tombatron/freddy-animatronic/docs/phase2-pcb.md

# Phase 2: controller PCB (rev A, first draft)

A carrier board that replaces the stock SD03-122. The ESP32-S3 and the power and driver parts are off-the-shelf modules on headers, so rev A is easy to hand-solder, debug and rework. A later revision can put the parts directly on the board once the design has proven itself.

**Status:** schematic draft and placement sketch. Not in KiCad yet. Modules are ordered (generic DRV8876, TB6612 and MP1584 boards instead of the Pololu ones first planned); their footprints get confirmed from the real boards before layout. The [power test](phase2-power-test.md) is the last design check.

| Sheet | File |
| --- | --- |
| 1. Power | [controller_power.svg](../schematics/controller_power.svg) |
| 2. Motor drivers | [controller_motors.svg](../schematics/controller_motors.svg) |
| 3. Elbows, sensors, inputs | [controller_signals.svg](../schematics/controller_signals.svg) |
| 4. Audio | [controller_audio.svg](../schematics/controller_audio.svg) |
| 5. ESP32-S3 pin map | [controller_esp32.svg](../schematics/controller_esp32.svg) |
| Placement (to scale) | [placement.svg](../hardware/controller/placement.svg) |
| BOM | [bom.csv](../hardware/controller/bom.csv) |
| Net list | [netlist.csv](../hardware/controller/netlist.csv) |

All of these are generated by `tools/make_controller_schematics.py` (except the CSVs). The sheets use net labels: two pins with the same net name are connected.

## Block diagram

```mermaid
flowchart LR
    J1["J1 7.2–7.6V in"] --> F1["F1 5A + Q1 reverse protect<br/>C1 1000µF, D1 TVS"]
    F1 --> VMOT(("VMOT"))
    VMOT --> U1["U1 S7V7F5<br/>+5V_LOGIC"]
    VMOT --> U2["U2 MP1584 buck<br/>+5V_AUDIO"]
    VMOT --> U3["U3 DRV8876<br/>right shoulder"]
    VMOT --> U4["U4 DRV8876<br/>left shoulder"]
    VMOT --> U5["U5 TB6612<br/>eye motor + LEDs"]
    VMOT --> EL["J4 / J7 elbow power"]
    U1 --> ESP["ESP32-S3<br/>DevKitC-1 N16R8"]
    U2 --> AMP["U6 MAX98357A"] --> SPK["J15 speaker"]
    ESP -- "IN1/IN2 PWM, CS" --> U3 & U4
    ESP -- "IN PWM" --> U5
    ESP -- "UART TX 9600" --> EL
    ESP -- "I2S" --> AMP
    MIC["J16 INMP441 (optional)"] -- I2S --> ESP
    SW["Shoulder switches, eye home,<br/>trigger, PIR"] --> ESP
    ESP <-- I2C --> Q["J14 Qwiic: INA219, MPU6050"]
```

## Design choices

- **Modules, not bare chips (rev A).** The driver and regulator modules already have their bypass caps, current-sense resistors and thermal copper. Each one sits on 0.1" headers, so a dead driver is a 30-second swap.
- **Three rails.** VMOT is the raw adapter after the fuse. It drives the shoulders, eye motor and elbows directly, as the stock board does. Logic and audio each get their **own regulator**, because a class-D amp on the ESP32's rail would put noise on WiFi and the ADC. Logic uses a **buck-boost** (Pololu S7V7F5) because the adapter sags to ~4.9V during a lift. Audio uses a plain **buck** (MP1584): the amp runs from 2.5 to 5.5V, so a sag only makes it a little quieter.
- **D2 Schottky into the ESP32's 5V pin**, so plugging in USB while the board is powered can't backfeed the regulator (and the other way around).
- **DRV8876 for the shoulders** instead of the DRV8871 from the plan. It runs down to 4.5V (the DRV8871 needs 6.5V, and the adapter sags to ~4.9V), has IN/IN control and an analog current output (IPROPI), so the ESP32 can see a stall or a "the arm hit the stop" spike. That covers most of what the INA219 was for. It's rated 1.3A continuous, 3.5A peak: a normal lift is 0.5–1A; a 1.8A stall hits its current limit, and the firmware stops on stalls anyway. (The DRV8874, 2.1A continuous, is the upgrade path if more headroom is ever needed.)
- **TB6612 for the head.** Channel A runs the eye motor (one direction, but the H-bridge gives braking). Channel B runs the LEDs (measured: one direction, yellow +, ~2.8V at ~20mA). R3 = 220Ω sets about the stock brightness at full on; PWM dims and flickers.
- **Every external input** has a 1k series resistor and a pull resistor. The trigger jack (the only user-facing input) also gets a TVS. The PIR output only reaches ~1.3V on motion (measured), which is too low to read reliably as a digital input on a 3.3V ESP32. So GPIO9 reads it with the **ADC** (it's on ADC1) against a ~0.6V threshold, with a 100k pulldown so an unplugged sensor reads idle. The BAT54S clamp stays as protection.
- **Audio:** MAX98357A (I2S in, 3W class D out, no DAC needed). The INMP441 microphone shares BCLK/WS, so it's one full-duplex I2S bus and costs only one extra GPIO.

## GPIO map

| GPIO | Net | Use |
| --- | --- | --- |
| 1 | VMON | Supply voltage, 47k/22k divider (ADC1) |
| 2 | CS_R | Right shoulder current (ADC1) |
| 4 | CS_L | Left shoulder current (ADC1) |
| 5 | SW_SH_R | Right shoulder switch |
| 6 | SW_SH_L | Left shoulder switch |
| 7 | SW_EYE | Eye home switch (10k pull-up) |
| 8 | TRIG | Trigger jack (10k pull-up) |
| 9 | PIR | PIR output, read as analog (ADC1), ~1.3V = motion |
| 10 | I2S_DIN | Microphone data |
| 11, 12 | SH_R_IN1/2 | Right shoulder DRV8876 (PWM) |
| 13, 14 | SH_L_IN1/2 | Left shoulder DRV8876 (PWM) |
| 15, 16 | I2C_SDA/SCL | Qwiic header |
| 17 | ELBOW_R_TX | UART1 TX, right elbow |
| 18 | ELBOW_L_TX | UART2 TX, left elbow |
| 21 | I2S_WS | I2S word select |
| 38, 39 | EYE_M1/2 | TB6612 channel A, eye motor |
| 40 | I2S_BCLK | I2S bit clock |
| 41, 42 | EYE_L1/2 | TB6612 channel B, eye LEDs |
| 47 | I2S_DOUT | Amp data |
| 48 | — | Onboard RGB LED (status) |

Avoided: strapping pins 0, 3, 45, 46; USB 19, 20; octal PSRAM 35–37; UART0 43, 44 (kept for the serial console). No clean GPIOs are left. GPIO 3, 45 and 46 can still drive outputs (with care at boot), and the Qwiic header is the main expansion port.

## Connectors

**Drop-in: Freddy's harness is not modified.** Each harness connection is a short **pre-made JST SM pigtail** (the inline 2.54 mm connectors Freddy already uses) soldered straight into plated pads on the board, and Freddy's original plugs mate with them. Pigtail gender is the opposite of Freddy's ends; pin counts match Freddy's plugs. Pads: 1.2 mm drill, 2.54 mm spacing (20–22 AWG), with a pair of zip-tie holes behind each group for strain relief. Silkscreen next to every pad group: the cable name and Freddy's wire colors. **Mix-ups:** Freddy's own plugs set the sizes, and the head cables and shoulder motors are all 2-pin, so the pigtails are grouped by body part (arm pigtails at each arm end, head pigtails together) and each gets a heat-shrink label. The one harmful swap is the eye LED plug onto a shoulder motor pigtail. Wire colors below are Freddy's, and pin 1 is listed first.

| Ref | Goes to | Pins |
| --- | --- | --- |
| J1 | Adapter | 5.5×2.1 barrel, center + (plus a 2-pin screw terminal footprint in parallel) |
| J3 / J6 | Right / left shoulder motor (cable 1) | 1 OUT1, 2 OUT2 |
| J4 / J7 | Right / left elbow (cable 2) | 1 GND, 2 VMOT, 3 signal |
| J5 / J8 | Right / left shoulder switch (cable 3) | 1 +3V3 (red), 2 GND (black), 3 switch (yellow), 4 white (test point only) |
| J9 | Eye home switch (head cable 1) | 1 switch (yellow), 2 GND (white) |
| J10 | Eye LEDs (head cable 2) | 1 LED + (yellow), 2 LED − (white) |
| J11 | Eye motor (head cable 3) | 1 motor (yellow), 2 motor (orange) |
| J12 | Trigger | 3.5mm mono jack: tip = TRIG, sleeve = GND |
| J13 | PIR | 1 VMOT (yellow, power), 2 signal (orange), 3 GND (black). Powered from VMOT, as the stock board does |
| J14 | I2C | JST-SH 4-pin Qwiic: GND, 3V3, SDA, SCL |
| J15 | Speaker | 2-pin, 4–8Ω |
| J16 | INMP441 module | 1×6 female header |
| JP1 | Amp gain | 3-pin jumper (9 / 12 / 15 dB) |

## Power budget

| Load | Rail | Typical | Peak |
| --- | --- | --- | --- |
| Shoulder motor, each | VMOT | 0.5–1A while lifting | 1.8A stall |
| Elbow module, each | VMOT | ~0.1A | ~0.5A moving (estimate) |
| Eye motor + LEDs | VMOT | ~0.1A (motor 80–90mA measured, LEDs ~20mA) | ~0.4A (motor start, estimate) |
| ESP32-S3 (WiFi on) | +5V_LOGIC | 0.15A | 0.5A bursts |
| Speaker amp, 3W into 4Ω | +5V_AUDIO | 0.3A | 0.8A |

Worst case is both shoulders stalled while audio plays: about 5A, which is right at the fuse. The stock show never lifts both arms at full drive at once, and the firmware can stop that from ever happening (stagger lifts, or use the CS readings). A **7.5V 6A adapter** is still recommended.

## Layout guidelines

- 100×80 mm, 2 layers, 1 oz copper, M3 holes in the corners. See [placement.svg](../hardware/controller/placement.svg).
- Power enters top-left. Harness connectors run along the bottom edge in body order (right arm, head, left arm, inputs). Audio sits top-right, away from the motor drivers.
- Bottom layer: solid ground pour. Motor return currents go straight back to J1 on wide copper (star point at J1). Do not route motor current under the ESP32 or the amp.
- VMOT traces: ≥2 mm wide (≈3A at a 10°C rise on 1 oz), or a pour. Shoulder outputs: ≥1.5 mm.
- Keep the ESP32 antenna end past the board edge or over a copper-free cutout.
- Test points on VMOT, +5V_LOGIC, +5V_AUDIO, +3V3, GND, both elbow TX lines, and each FAULT pin.

## Open questions

1. **Cable 3 white wire.** Still unknown. It goes to a test point only, so nothing depends on it.
2. **RGB LED pin.** DevKitC-1 v1.0 uses GPIO48 for the RGB LED; v1.1 uses GPIO38, which this map gives to the eye motor. With a v1.1 board the LED will flicker while the eyes move (harmless), or swap GPIO38 and GPIO48.
3. **Elbow current.** Not measured yet. Add an INA219 on J14 during bring-up to log it.

## Next steps

1. Run the [breadboard power test](phase2-power-test.md): check the 5V rail stays up during a full-drive lift. Optionally read the PIR on GPIO9 at the same time (motion should read clearly above 0.6V).
2. Photograph and measure the generic DRV8876, TB6612 and MP1584 modules; update the footprints to match.
3. Capture the schematic in KiCad (one sheet per SVG above), assign footprints, lay out from the placement sketch.
4. Order 5 boards (JLCPCB, ~$20).
5. Bring-up order: power only → ESP32 → one subsystem at a time, re-using the Phase 1 test sketches.
