tombatron/freddy-animatronic/docs/images/stock_board_3.jpeg

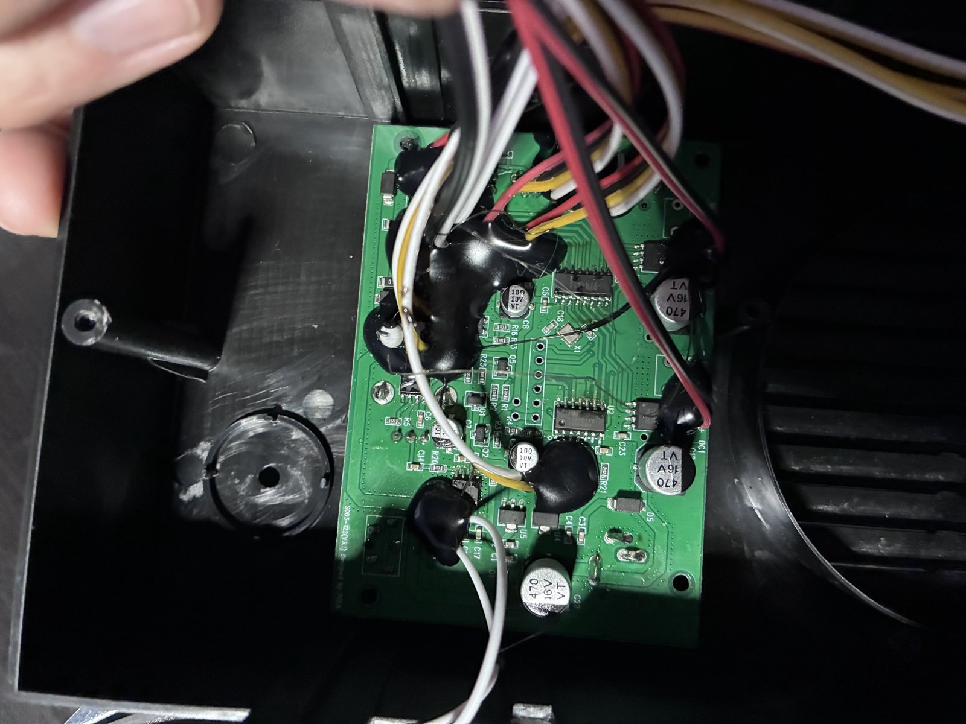
docs/images/stock_board_3.jpeg
