tombatron/freddy-animatronic/(commit log)

2026-11-12 Initial commit.
    [head_show.csv, left_shoulder.csv, right_arm_run1.csv, right_arm_run2_left_connected.csv, right_arm_run3_elbow_marked.csv]
2026-11-12 Phase 2
    [bom.csv, netlist.csv]
2026-11-14 Phase 2: bench tests, parts as ordered, pigtail harness, doc review
    [bom.csv, netlist.csv]
